Innovive/rack_programer-hardware/Documents/ESP32s pinout.jpg

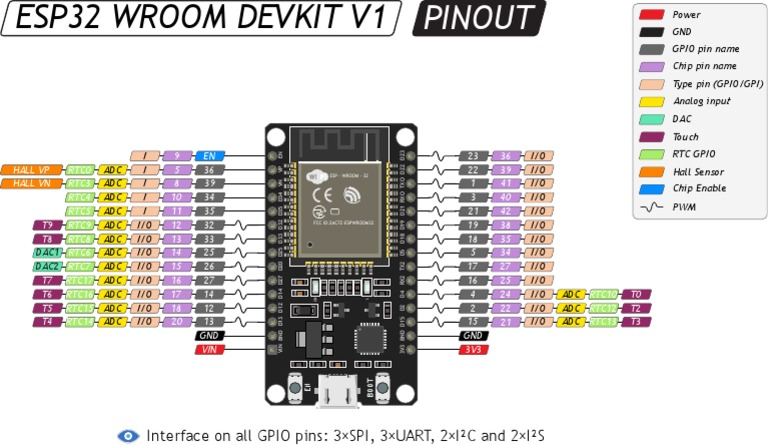
Documents/ESP32s pinout.jpg
