Innovive/rack_programer-hardware/README.md

# rack_programer-hardware
Hardware tool for continuous integration and engineering testing for 3.5 racks
