Innovive/rack_programer-hardware/Documents/CI Device.docx

# Continuous Integration Device

Boost converter website

https://webench.ti.com/power-designer/switching-regulator/customize/5?noparams=0
