Innovive/rack_programer-hardware/Documents/boost converter.PNG

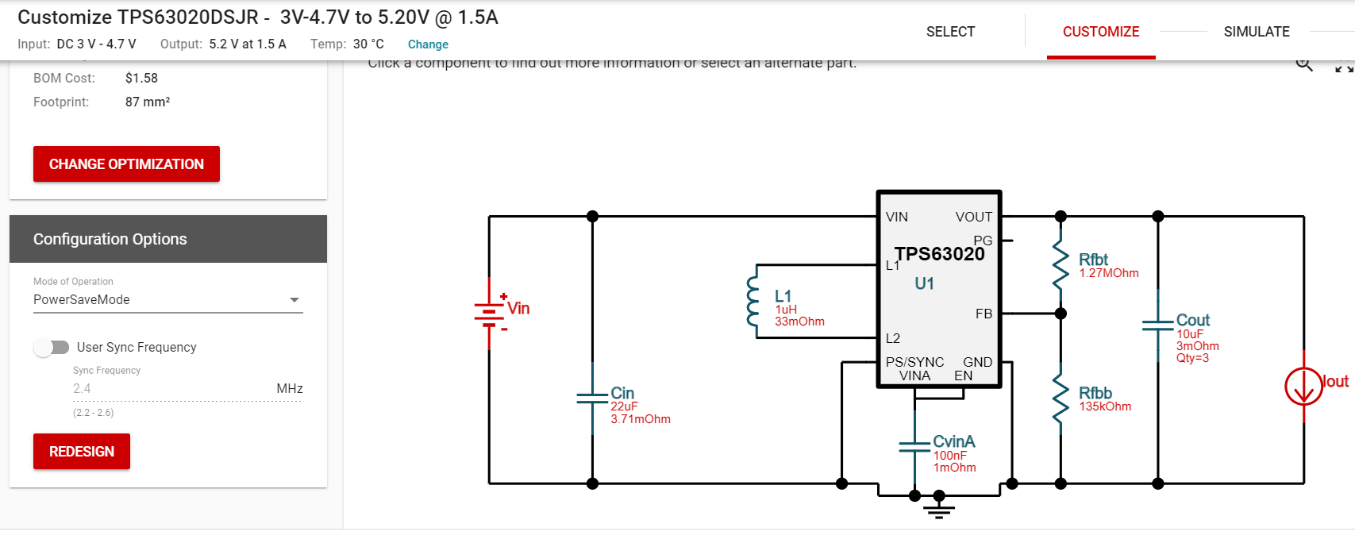
Documents/boost converter.PNG
