Innovive/rack_programer-hardware/Documents/BuckConverter.PNG

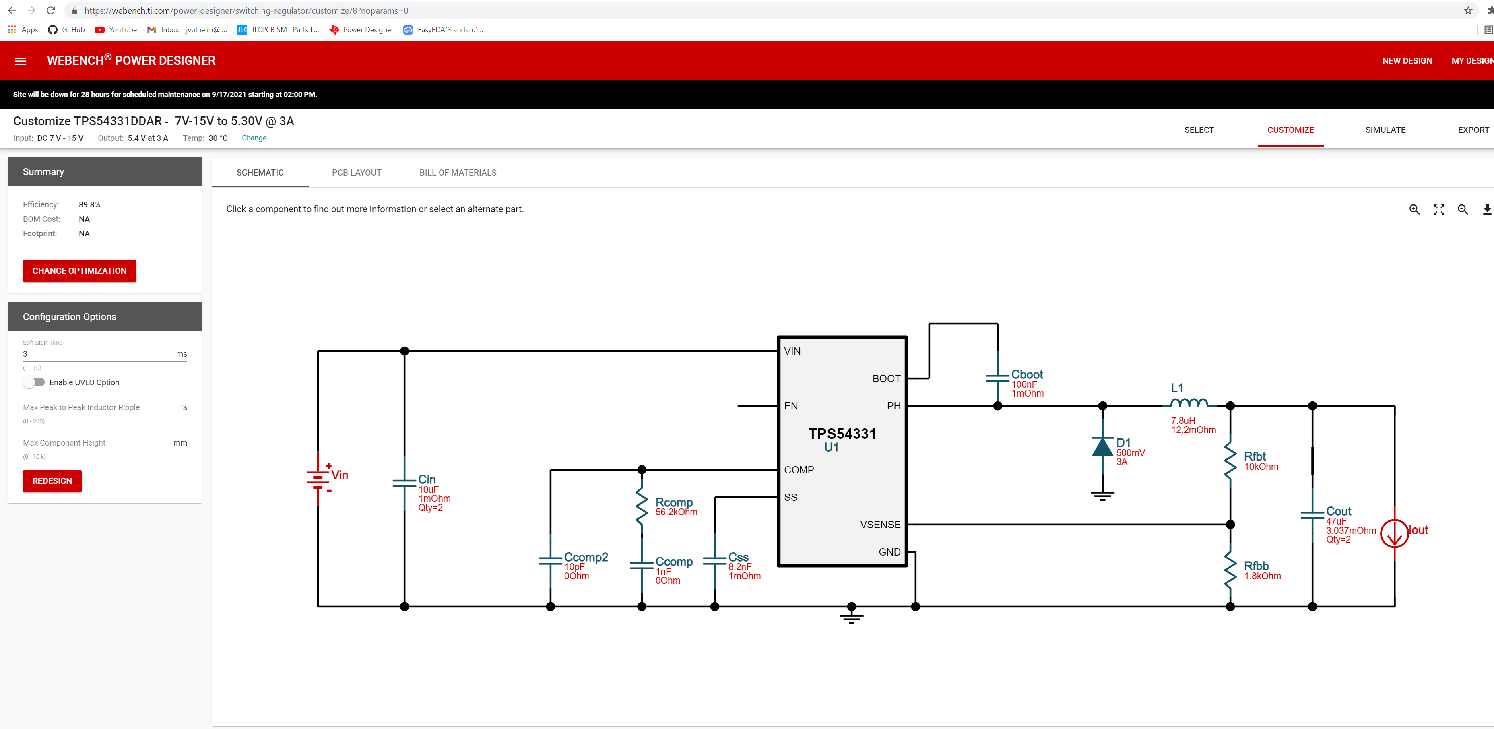
Documents/BuckConverter.PNG
