Innovive/rack_programer-hardware/(threads)

Thread 10 (2021-08-18):

Prevent Controller error while in device mode

jvolheim1, 2021-08-18:
Allow the device to operate while the controller is attached but not erroring out.
will likely require returning values to placate the controller

Thread 3 (2021-08-18):

12v down circuit protection

jvolheim1, 2021-08-18:
design circuit to protect the device from improper voltage from the rack

kalan-innovive, 2021-08-19:
Short circuit or current limiting detection. The board should not draw more than 1.5 Amps

jvolheim1, 2021-09-02:
Add mosfet for reverse voltage protection

jvolheim1, 2021-09-02:
Look at standard ethernet cable pinot to protect the circuit from possible connection with 34v

Thread 5 (2021-08-18):

12v to 5v converter upgrade

jvolheim1, 2021-08-18:
Need a new part or integrated circuit for the device to manage the power coming down from the rack as the current one requires adjustment and in unreliable

Closed 2021-08-24.

Thread 13 (2021-08-19):

4.2v to 5v replacement

jvolheim1, 2021-08-19:
replace the buck converter module in the pcb with a built in circuit design that doesn't need adjustment

Thread 17 (2021-08-19):

Check reverse polarity protection for the battery

jvolheim1, 2021-08-19:
what happens if the battery is put in backwards

Thread 18 (2021-08-19):

Check power losses and reverse currents of diodes in circuit

jvolheim1, 2021-08-19:
We may want to use a p-channel mosfet as show in this video.
https://www.youtube.com/watch?v=IrB-FPcv1Dc

Thread 19 (2021-08-19):

Buck Converter pinning Correction

jvolheim1, 2021-08-19:
The Vi pin and Vo pin are Backwards on the PCB

jvolheim1, 2021-08-19:
Fixed on PCB but will have to flip component on boards coming

Closed 2021-08-19.

Thread 21 (2021-08-24):

Design the power switching circuit

jvolheim1, 2021-08-24:
The power switching circuit should decide base on a hierarchy of rack then usb followed by battery

Thread 28 (2021-08-26):

Create daughter board for rs485 ttl transmitters

jvolheim1, 2021-08-26:
The daughter board should be able to fit on previous device boards and soldered in place of the two separate modules

Closed 2021-09-17.

Thread 35 (2021-09-02):

Add UART to rj485 connector for controller

kalan-innovive, 2021-09-02:
Add UART to RS485 to communicate with the controller on pins 3 and 6 of the RS485 connector.
RS485 pin 6 to the rack should be connected to a GPIO so  that can be pulled low if the controller is connected.

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

Thread 36 (2021-09-17):

12v to 5v test board

jvolheim1, 2021-09-17:
Get a test board printed.
Test the new layout to determine how the circuit behaves.
If the board works appropriately then add it to the main PCB

Thread 37 (2021-09-17):

3.8 to 5v test board

jvolheim1, 2021-09-17:
determine if a board with higher efficiency is needed
Create a test board
Test for effective behavior
if effective then add to main PCB
