Innovive/rack_programer-hardware/CI_ComPCB/CI_ComPCB.kicad_pcb

## KiCad design CI_ComPCB/CI_ComPCB.kicad_pcb (2021-12-14)

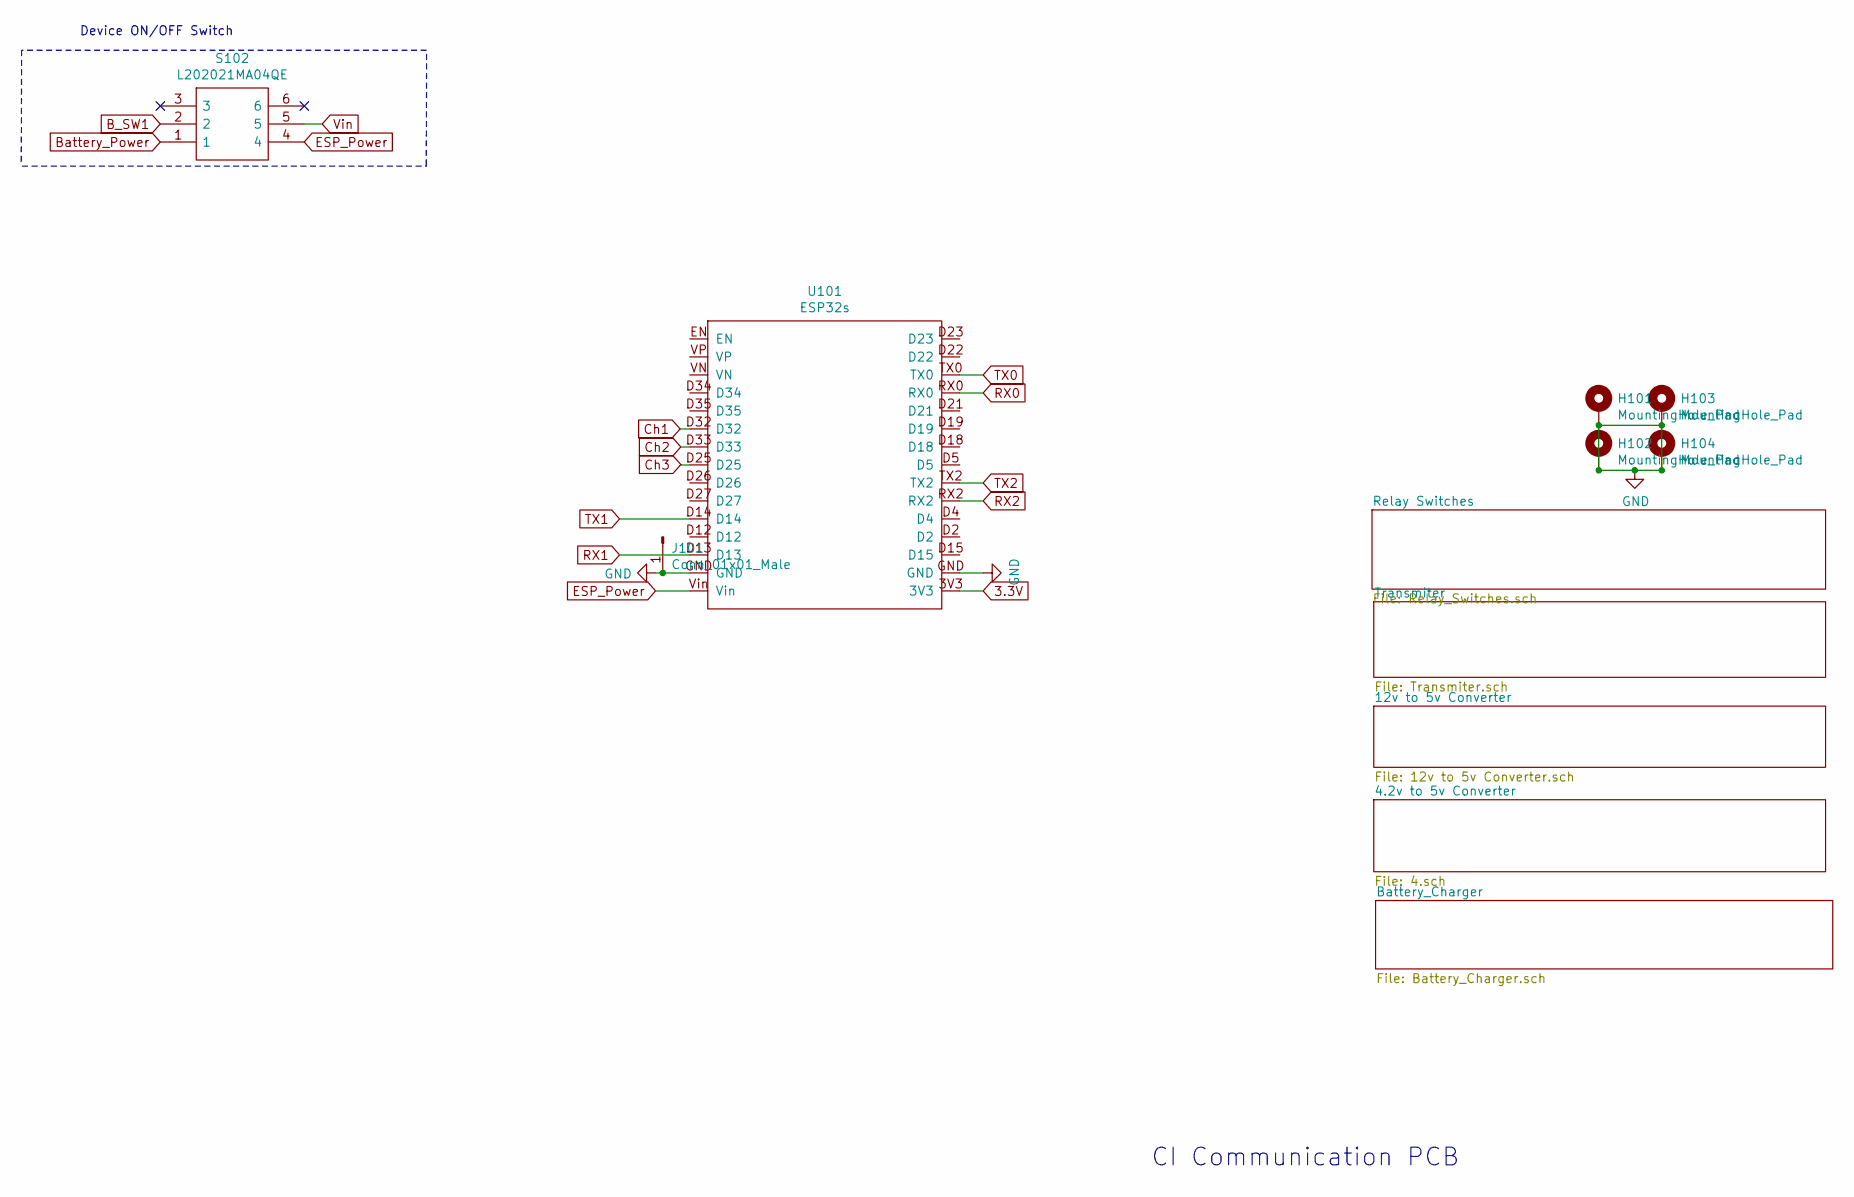
[picture p9: schematic CI_ComPCB.sch]

Parts:
H101, H102, H103, H104: MountingHole_Pad; MountingHole_3.2mm_M3_ISO7380_Pad_TopBottom
J101: Conn_01x01_Male; PinHeader_1x01_P2.54mm_Vertical
S102: L202021MA04QE; Mouser Part Number 611-L202021MA04QE
U101: ESP32s

Connections:
3.3V: U101.3V3; also elsewhere on the board
B_SW1: S102.2; also elsewhere on the board
Battery_Power: S102.1; also elsewhere on the board
Ch1: U101.D32; also elsewhere on the board
Ch2: U101.D33; also elsewhere on the board
Ch3: U101.D25; also elsewhere on the board
ESP_Power: S102.4, U101.Vin
GND: H101.1, H102.1, H103.1, H104.1, J101.1, U101.GND; also elsewhere on the board
RX0: U101.RX0; also elsewhere on the board
RX1: U101.D13; also elsewhere on the board
RX2: U101.RX2; also elsewhere on the board
TX0: U101.TX0; also elsewhere on the board
TX1: U101.D14; also elsewhere on the board
TX2: U101.TX2; also elsewhere on the board
Vin: S102.5; also elsewhere on the board

Notes on the sheet:
CI Communication PCB
Device ON/OFF Switch

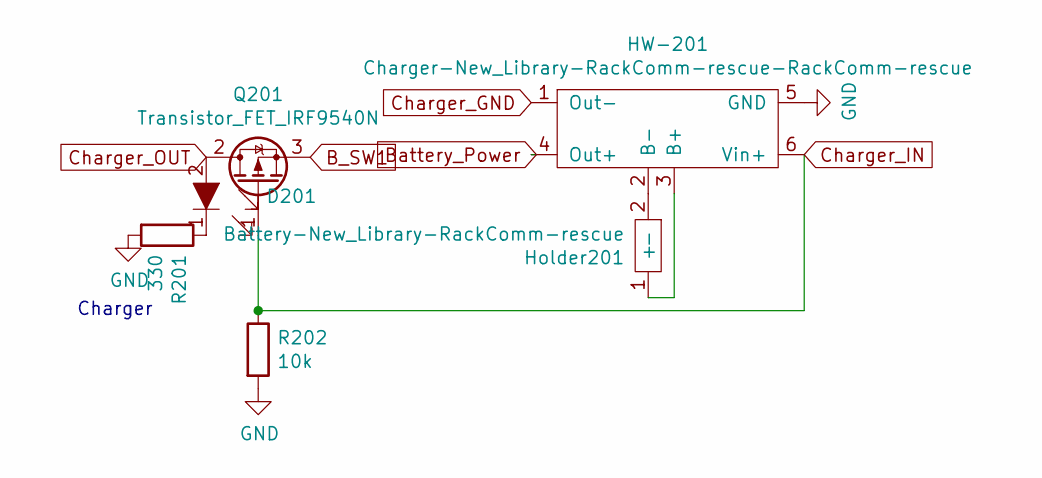
[picture p10: schematic Battery_Charger.sch]

Parts:
D201: LTST-C190GKT; LED_0603; MPN LTST-C190GKT; Digi-Key_PN 160-1183-1-ND
HW-201: Charger-New_Library-RackComm-rescue-RackComm-resc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; Charger
Holder201: Battery-New_Library-RackComm-rescue; Battery
Q201: Transistor_FET_IRF9540N; TO-220-3_Vertical; JLCPCB C2575
R201: 330; R_0805_2012Metric
R202: 10k; R_0805_2012Metric

Connections:
B_SW1: Q201.3 (S); also elsewhere on the board
Battery_Power: HW-201.4 (Out+); also elsewhere on the board
Charger_GND: HW-201.1 (Out-)
Charger_IN: HW-201.6 (Vin+), Q201.1 (G), R202.1; also elsewhere on the board
Charger_OUT: D201.2, Q201.2 (D); also elsewhere on the board
GND: HW-201.5 (GND), R201.2, R202.2; also elsewhere on the board
unnamed: D201.1, R201.1
unnamed: HW-201.2 (B-), Holder201.2 (-)
unnamed: HW-201.3 (B+), Holder201.1 (+)

Notes on the sheet:
Charger

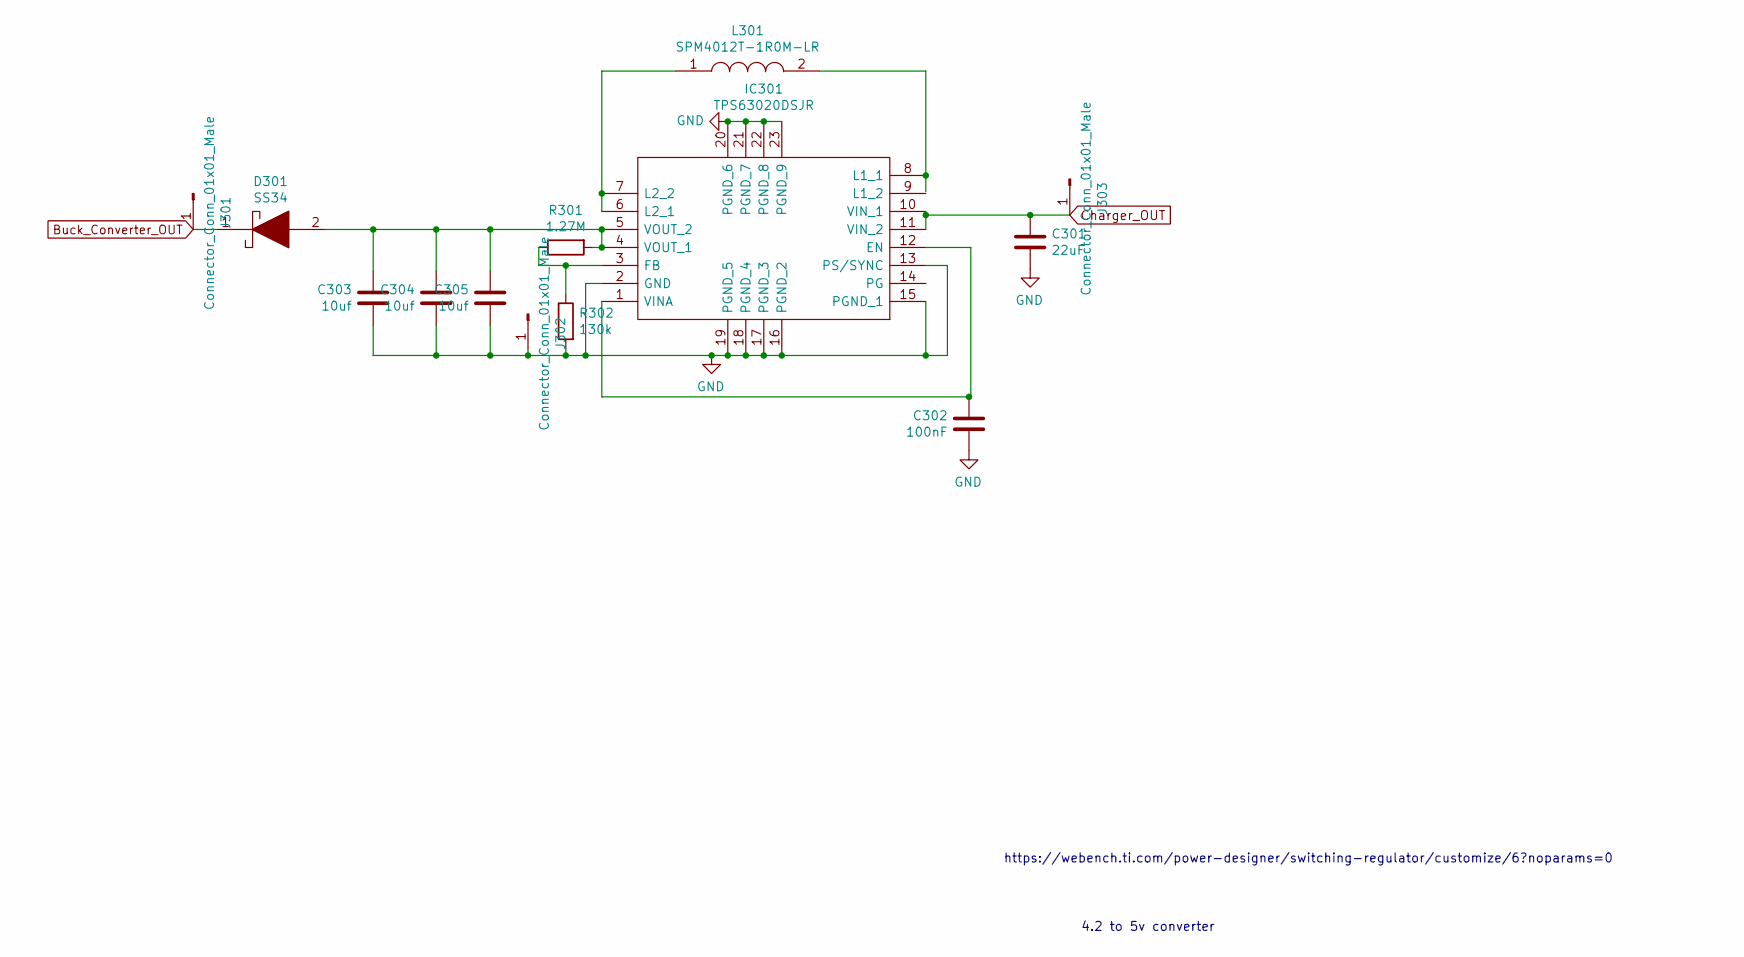
[picture p11: schematic 4.sch]

Parts:
C301: 22uF; C_0805_2012Metric
C302: 100nF; C_0805_2012Metric
C303, C304, C305: 10uf; C_0805_2012Metric
D301: SS34; DO-214AC; Mouser Part Number 512-SS34
IC301: TPS63020DSJR; Mouser Part Number 595-TPS63020DSJR
J301, J302, J303: Connector_Conn_01x01_Male; PinHeader_1x01_P2.54mm_Vertical
L301: SPM4012T-1R0M-LR; SPM4010-4020; Mouser Part Number 810-SPM4012T1R0MLR
R301: 1.27M; R_0603_1608Metric; JLCPCB C166902
R302: 130k; R_0805_2012Metric

Connections:
Buck_Converter_OUT: D301.1, J301.1; also elsewhere on the board
Charger_OUT: C301.1, IC301.10 (VIN_1), IC301.11 (VIN_2), J303.1; also elsewhere on the board
GND: C301.2, C302.2, C303.2, C304.2, C305.2, IC301.2 (GND), IC301.13 (PS/SYNC), IC301.15 (PGND_1), IC301.16 (PGND_2), IC301.17 (PGND_3), IC301.18 (PGND_4), IC301.19 (PGND_5), IC301.20 (PGND_6), IC301.21 (PGND_7), IC301.22 (PGND_8), IC301.23 (PGND_9), J302.1, R302.2; also elsewhere on the board
unnamed: C302.1, IC301.1 (VINA), IC301.12 (EN)
unnamed: C303.1, C304.1, C305.1, D301.2, IC301.4 (VOUT_1), IC301.5 (VOUT_2), R301.2
unnamed: IC301.3 (FB), R301.1, R302.1
unnamed: IC301.6 (L2_1), IC301.7 (L2_2), L301.1
unnamed: IC301.8 (L1_1), L301.2

Notes on the sheet:
4.2 to 5v converter
https://webench.ti.com/power-designer/switching-regulator/customize/6?noparams=0

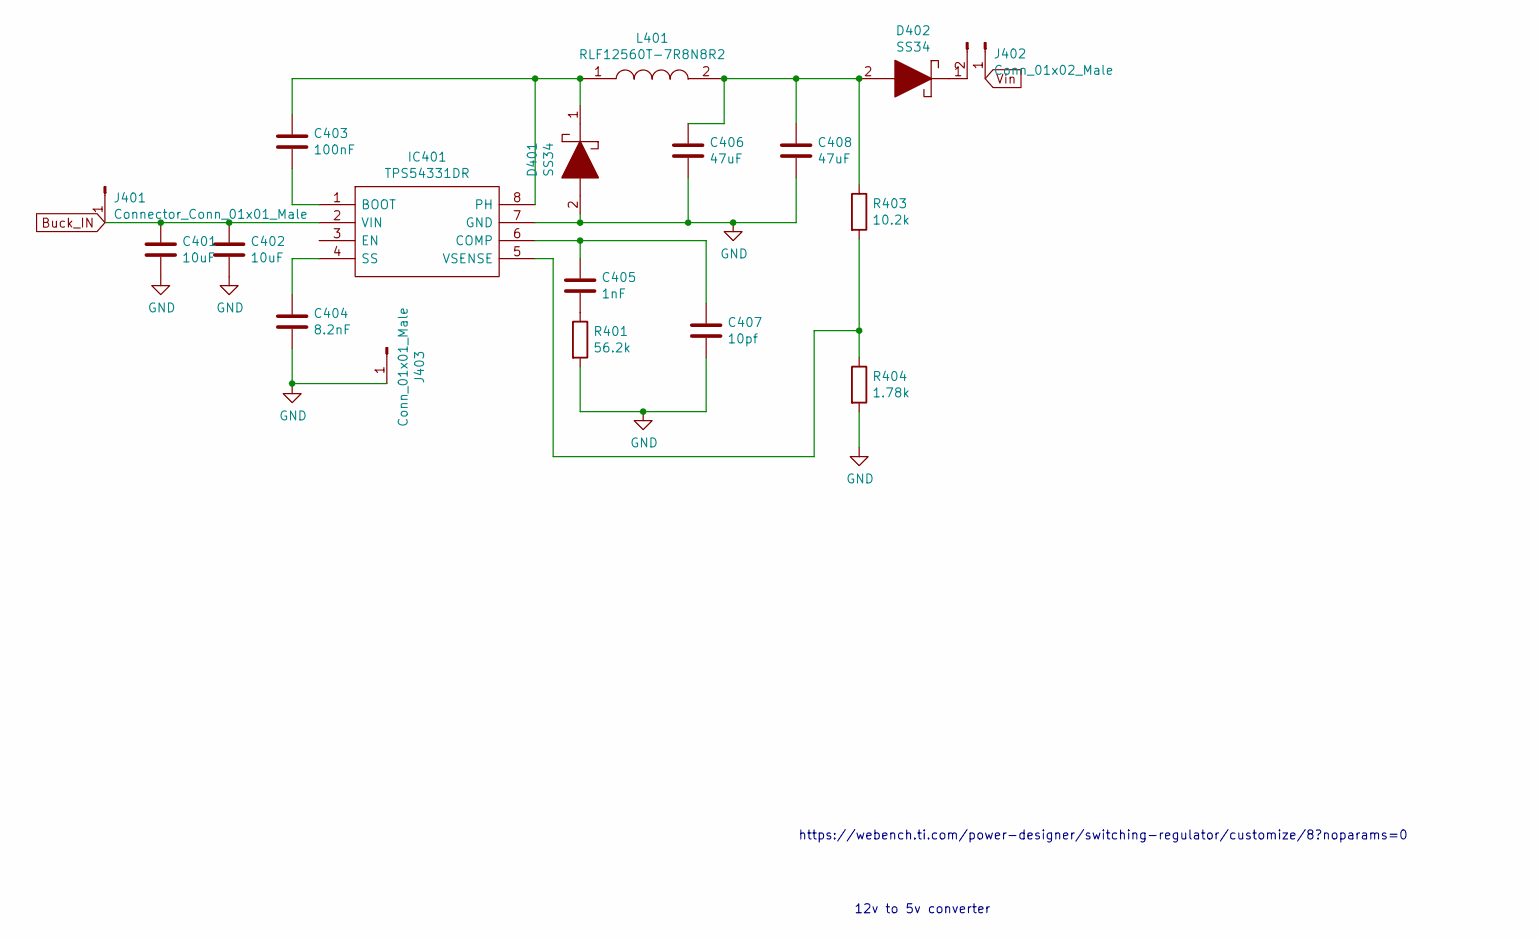
[picture p12: schematic 12v to 5v Converter.sch]

Parts:
C401, C402: 10uF; C_0805_2012Metric
C403: 100nF; C_0805_2012Metric
C404: 8.2nF; C_0603_1608Metric; JLCPCB C1032
C405: 1nF; C_0805_2012Metric
C406, C408: 47uF; C_0805_2012Metric
C407: 10pf; C_0805_2012Metric
D401, D402: SS34; DO-214AC; Mouser Part Number 512-SS34
IC401: TPS54331DR; SOIC127P600X175-8N; Mouser Part Number 595-TPS54331DR
J401: Connector_Conn_01x01_Male; PinHeader_1x01_P2.54mm_Vertical
J402: Conn_01x02_Male; PinHeader_1x02_P2.54mm_Vertical
J403: Conn_01x01_Male; PinHeader_1x01_P2.54mm_Vertical
L401: RLF12560T-7R8N8R2; INDPM128125X600N; Mouser Part Number 810-RLF12560T-7R8N
R401: 56.2k; R_0805_2012Metric
R403: 10.2k; R_0805_2012Metric
R404: 1.78k; R_0805_2012Metric

Connections:
Buck_IN: C401.1, C402.1, IC401.2 (VIN), J401.1; also elsewhere on the board
GND: C401.2, C402.2, C404.2, C406.2, C407.2, C408.2, D401.2, IC401.7 (GND), J403.1, R401.2, R404.2; also elsewhere on the board
unnamed: C403.1, D401.1, IC401.8 (PH), L401.1
unnamed: C403.2, IC401.1 (BOOT)
unnamed: C404.1, IC401.4 (SS)
unnamed: C405.1, C407.1, IC401.6 (COMP)
unnamed: C405.2, R401.1
unnamed: C406.1, C408.1, D402.2, L401.2, R403.1
unnamed: D402.1, J402.2
unnamed: IC401.5 (VSENSE), R403.2, R404.1
Vin: J402.1; also elsewhere on the board

Notes on the sheet:
12v to 5v converter
https://webench.ti.com/power-designer/switching-regulator/customize/8?noparams=0

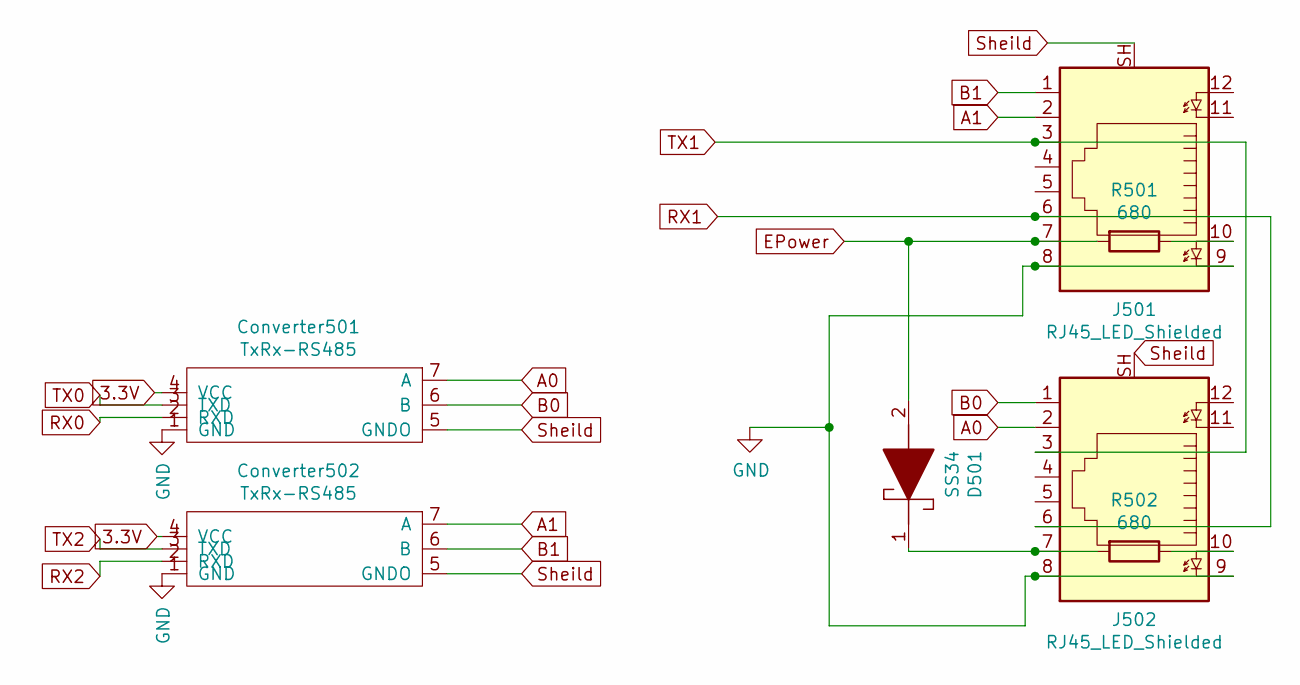
[picture p13: schematic Transmiter.sch]

Parts:
Converter501, Converter502: TxRx-RS485; TXRX-AB
D501: SS34; DO-214AC; Mouser Part Number 512-SS34
J501: RJ45_LED_Shielded; RJ45_Amphenol_RJHSE538X
J502: RJ45_LED_Shielded; RJ45_Amphenol_RJHSE538X; JLCPCB C464588
R501, R502: 680; R_0805_2012Metric

Connections:
3.3V: Converter501.4 (VCC), Converter502.4 (VCC); also elsewhere on the board
A0: Converter501.7 (A), J502.2
A1: Converter502.7 (A), J501.2
B0: Converter501.6 (B), J502.1
B1: Converter502.6 (B), J501.1
EPower: D501.2, J501.7, R501.2; also elsewhere on the board
GND: Converter501.1 (GND), Converter502.1 (GND), J501.8, J501.9, J502.8, J502.9; also elsewhere on the board
unnamed: D501.1, J502.7, R502.2
unnamed: J501.10, R501.1
unnamed: J502.10, R502.1
RX0: Converter501.2 (RXD); also elsewhere on the board
RX1: J501.6, J502.6; also elsewhere on the board
RX2: Converter502.2 (RXD); also elsewhere on the board
Sheild: Converter501.5 (GNDO), Converter502.5 (GNDO), J501.SH, J502.SH
TX0: Converter501.3 (TXD); also elsewhere on the board
TX1: J501.3, J502.3; also elsewhere on the board
TX2: Converter502.3 (TXD); also elsewhere on the board

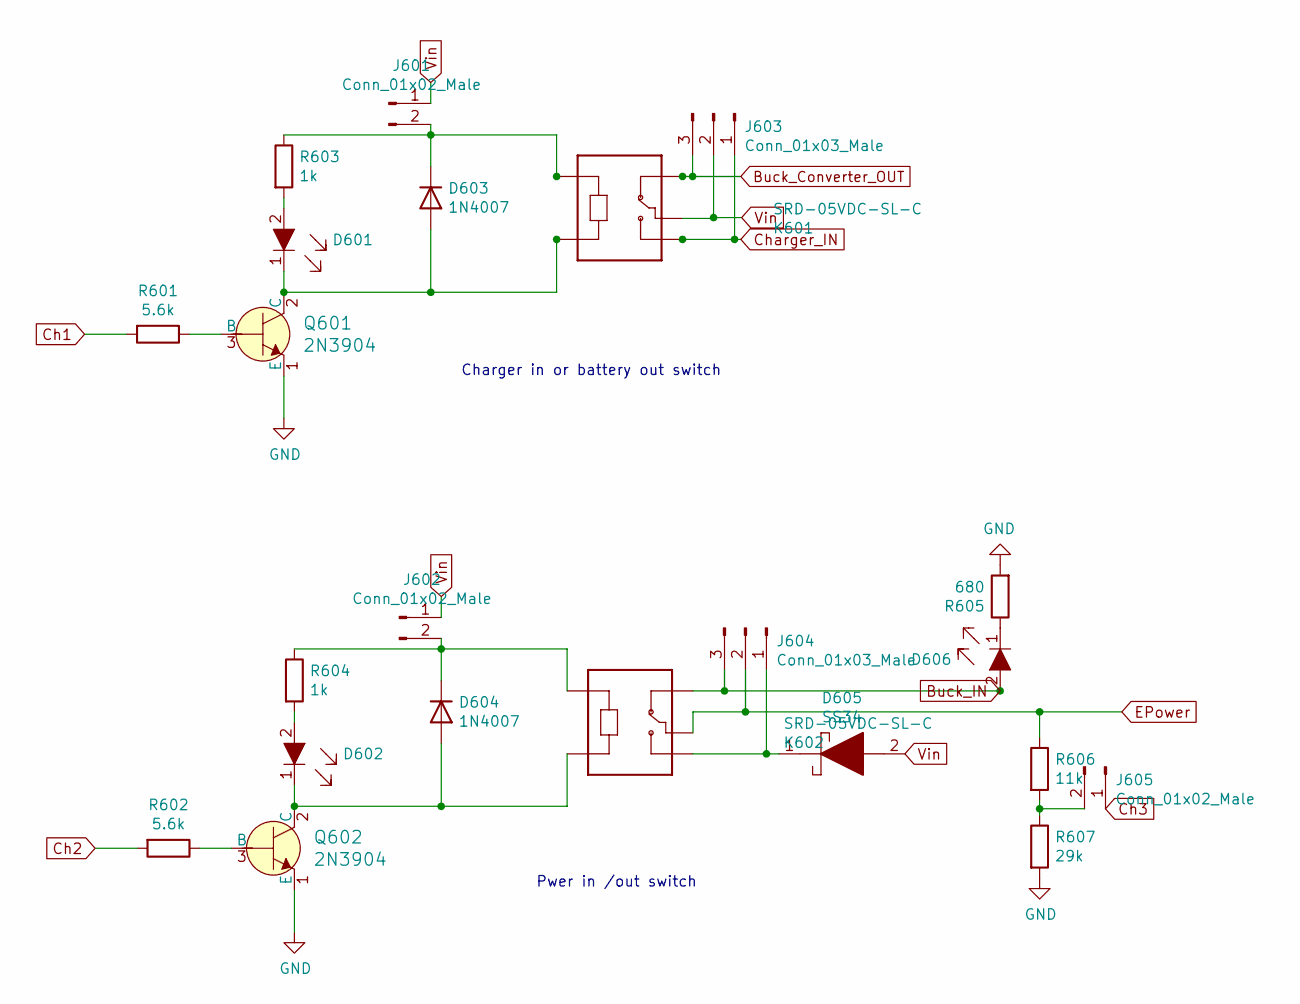
[picture p14: schematic Relay_Switches.sch]

Parts:
D601, D602, D606: LTST-C190GKT; LED_0603; MPN LTST-C190GKT; Digi-Key_PN 160-1183-1-ND
D603, D604: 1N4007; DO-214AC
D605: SS34; DO-214AC; Mouser Part Number 512-SS34
J601, J602, J605: Conn_01x02_Male; PinHeader_1x02_P2.54mm_Vertical
J603, J604: Conn_01x03_Male; PinHeader_1x03_P2.54mm_Vertical
K601, K602: SRD-05VDC-SL-C; RELAY_SRD-05VDC-SL-C; Manufacturer_Part_Number SRD-05VDC-SL-C
Q601, Q602: 2N3904; TO-92-3; MPN 2N3904; Digi-Key_PN 2N3904CS-ND
R601, R602: 5.6k; R_0805_2012Metric
R603, R604: 1k; R_0805_2012Metric
R605: 680; R_0805_2012Metric
R606: 11k; R_0805_2012Metric
R607: 29k; R_0805_2012Metric

Connections:
Buck_Converter_OUT: J603.3, K601.NC; also elsewhere on the board
Buck_IN: D606.2, J604.3, K602.NC; also elsewhere on the board
Ch1: R601.2; also elsewhere on the board
Ch2: R602.2; also elsewhere on the board
Ch3: J605.1; also elsewhere on the board
Charger_IN: J603.1, K601.NO; also elsewhere on the board
EPower: J604.2, K602.COM, R606.1; also elsewhere on the board
GND: Q601.1 (E), Q602.1 (E), R605.2, R607.2; also elsewhere on the board
unnamed: D601.1, D603.2 (A), K601.A1, Q601.2 (C)
unnamed: D601.2, R603.2
unnamed: D602.1, D604.2 (A), K602.A1, Q602.2 (C)
unnamed: D602.2, R604.2
unnamed: D603.1 (K), J601.2, K601.A2, R603.1
unnamed: D604.1 (K), J602.2, K602.A2, R604.1
unnamed: D605.1, J604.1, K602.NO
unnamed: D606.1, R605.1
unnamed: J605.2, R606.2, R607.1
unnamed: Q601.3 (B), R601.1
unnamed: Q602.3 (B), R602.1
Vin: D605.2, J601.1, J602.1, J603.2, K601.COM; also elsewhere on the board

Notes on the sheet:
Pwer in /out switch
Charger in or battery out switch

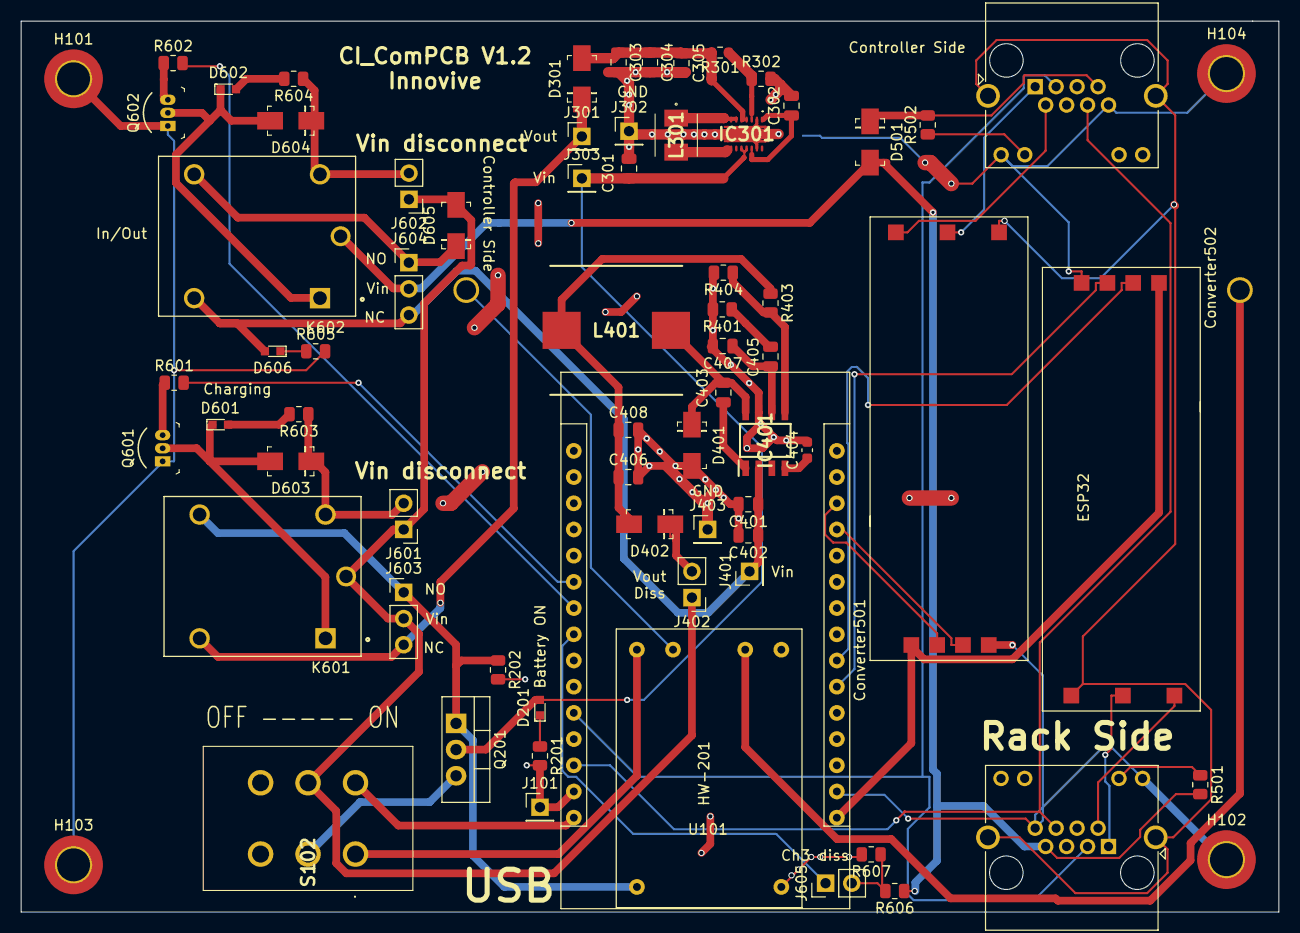
[picture p15: board CI_ComPCB.kicad_pcb from above]

Board: 2 copper layers, 121.9 x 86.4 mm, 73 parts (1 on the bottom side), 55 nets.
