Innovive/rack_programer-hardware/CI_ComPCB/12 to 5v converter/12 to 5v converter.kicad_pcb

## KiCad design CI_ComPCB/12 to 5v converter/12 to 5v converter.kicad_pcb (2021-09-17)

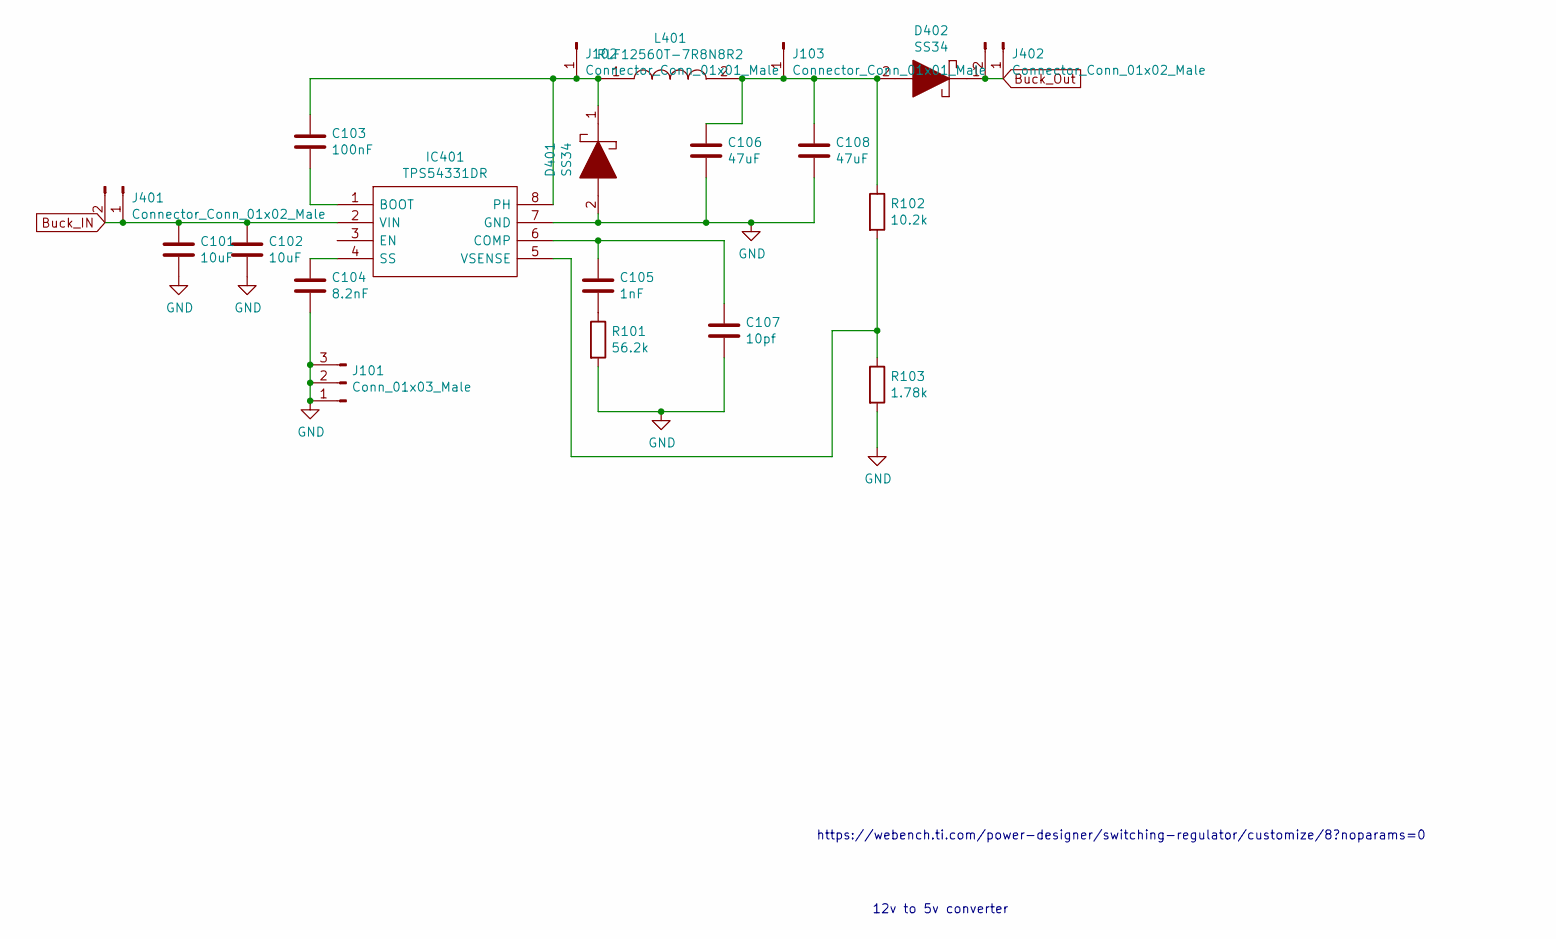
[picture p16: schematic 12 to 5v converter.sch]

Parts:
C101, C102: 10uF; C_0805_2012Metric
C103: 100nF; C_0805_2012Metric
C104: 8.2nF; C_0805_2012Metric; JLCPCB C1032
C105: 1nF; C_0805_2012Metric
C106, C108: 47uF; C_0805_2012Metric
C107: 10pf; C_0805_2012Metric
D401, D402: SS34; DO-214AC; Mouser Part Number 512-SS34
IC401: TPS54331DR; SOIC127P600X175-8N; Mouser Part Number 595-TPS54331DR
J101: Conn_01x03_Male; PinHeader_1x03_P2.54mm_Vertical
J102, J103: Connector_Conn_01x01_Male; PinHeader_1x01_P2.54mm_Vertical
J401, J402: Connector_Conn_01x02_Male; PinHeader_1x02_P2.54mm_Vertical
L401: RLF12560T-7R8N8R2; INDPM128125X600N; Mouser Part Number 810-RLF12560T-7R8N
R101: 56.2k; R_0805_2012Metric
R102: 10.2k; R_0805_2012Metric
R103: 1.78k; R_0805_2012Metric

Connections:
Buck_IN: C101.1, C102.1, IC401.2 (VIN), J401.1, J401.2
Buck_Out: D402.1, J402.1, J402.2
GND: C101.2, C102.2, C104.2, C106.2, C107.2, C108.2, D401.2, IC401.7 (GND), J101.1, J101.2, J101.3, R101.2, R103.2
unnamed: C103.1, D401.1, IC401.8 (PH), J102.1, L401.1
unnamed: C103.2, IC401.1 (BOOT)
unnamed: C104.1, IC401.4 (SS)
unnamed: C105.1, C107.1, IC401.6 (COMP)
unnamed: C105.2, R101.1
unnamed: C106.1, C108.1, D402.2, J103.1, L401.2, R102.1
unnamed: IC401.5 (VSENSE), R102.2, R103.1

Notes on the sheet:
12v to 5v converter
https://webench.ti.com/power-designer/switching-regulator/customize/8?noparams=0

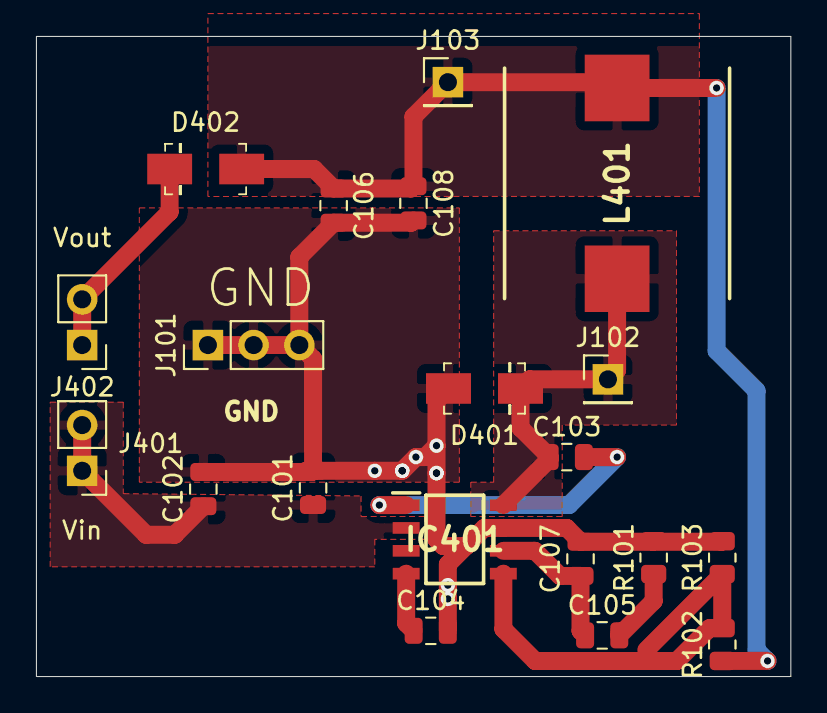
[picture p17: board 12 to 5v converter.kicad_pcb from above]

Board: 2 copper layers, 41.9 x 35.6 mm, 20 parts (0 on the bottom side), 10 nets.
