Innovive/rack_programer-hardware/CI_ComPCB/Max 485 transmitter/Max 485 transmitter.kicad_pcb

## KiCad design CI_ComPCB/Max 485 transmitter/Max 485 transmitter.kicad_pcb (2021-09-17)

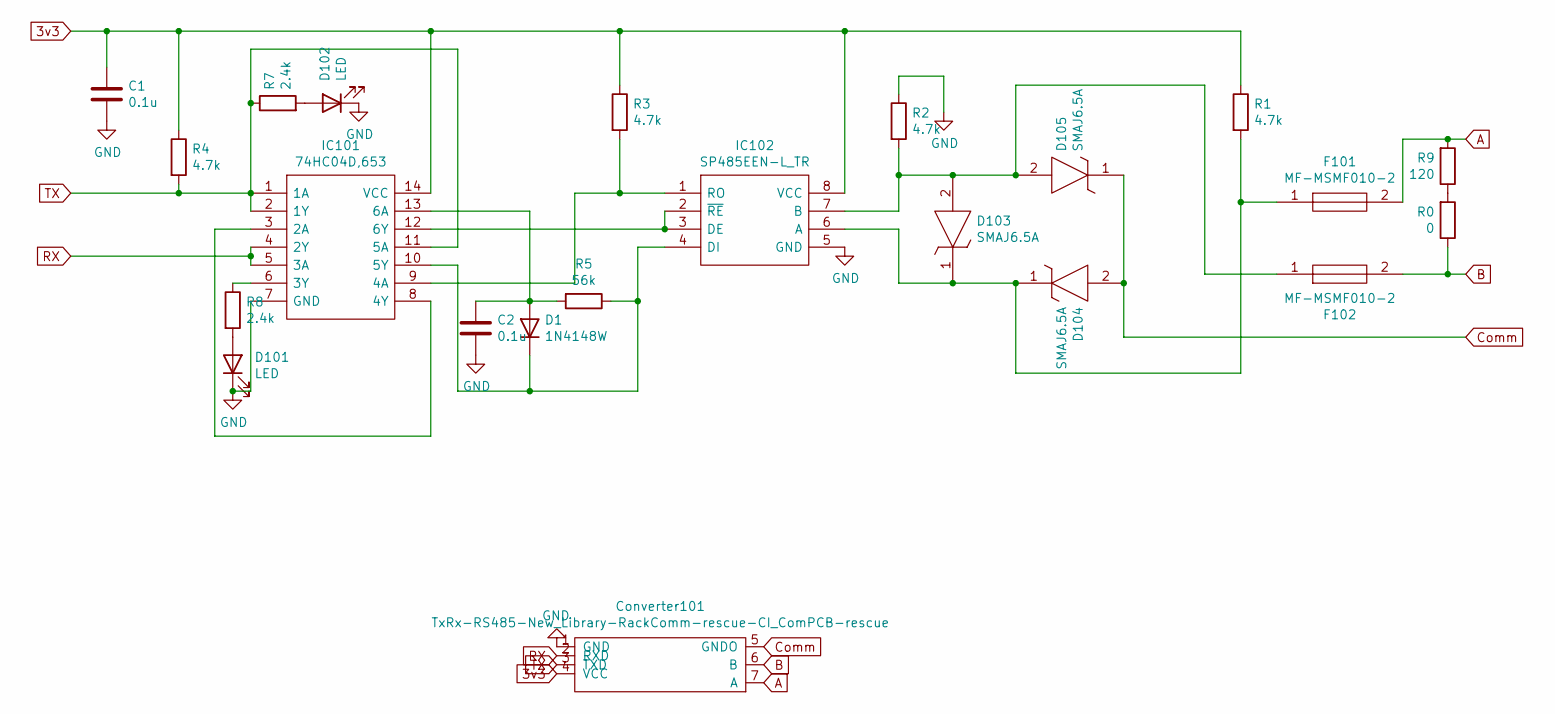
[picture p18: schematic Max 485 transmitter.sch]

Parts:
C1, C2: 0.1u; C_0402_1005Metric
Converter101: TxRx-RS485-New_Library-RackComm-rescue-CI_ComPCB-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; TXRX-AB
D1: 1N4148W; D_SOD-123
D101, D102: LED; LED_0603
D103, D104, D105: SMAJ6.5A; DIOM5026X229N; Mouser Part Number 576-SMAJ6.5A
F101, F102: MF-MSMF010-2; FUSC4632X110N; Mouser Part Number 652-MF-MSMF010-2
IC101: 74HC04D,653; SOIC127P600X175-14N; Mouser Part Number 771-74HC04D-T
IC102: SP485EEN-L_TR; SOIC127P600X175-8N; Mouser Part Number 701-SP485EEN-L/TR
R0: 0; R_0402_1005Metric
R1, R2, R3, R4: 4.7k; R_0402_1005Metric
R5: 56k; R_0402_1005Metric
R7, R8: 2.4k; R_0402_1005Metric
R9: 120; R_0402_1005Metric

Connections:
3v3: C1.1, Converter101.4 (VCC), IC101.14 (VCC), IC102.8 (VCC), R1.1, R3.1, R4.1
A: Converter101.7 (A), F101.2, R9.2
B: Converter101.6 (B), F102.2, R0.1
Comm: Converter101.5 (GNDO), D104.2, D105.1
GND: C1.2, C2.2, Converter101.1 (GND), D101.1 (K), D102.1 (K), IC101.7 (GND), IC102.5 (GND), R2.1
unnamed: C2.1, D1.2 (A), IC101.13 (6A), R5.2
unnamed: D1.1 (K), IC101.10 (5Y), IC102.4 (DI), R5.1
unnamed: D101.2 (A), R8.2
unnamed: D102.2 (A), R7.2
unnamed: D103.1, D104.1, F101.1, IC102.6 (A), R1.2
unnamed: D103.2, D105.2, F102.1, IC102.7 (B), R2.2
unnamed: IC101.3 (2A), IC101.8 (4Y)
unnamed: IC101.6 (3Y), R8.1
unnamed: IC101.9 (4A), IC102.1 (RO), R3.2
unnamed: IC101.12 (6Y), IC102.2 (~RE), IC102.3 (DE)
unnamed: R0.2, R9.1
RX: Converter101.2 (RXD), IC101.4 (2Y), IC101.5 (3A)
TX: Converter101.3 (TXD), IC101.1 (1A), IC101.2 (1Y), IC101.11 (5A), R4.2, R7.1

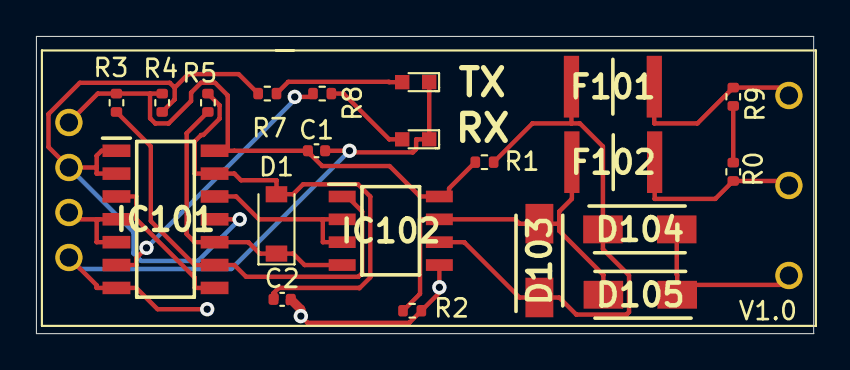
[picture p19: board Max 485 transmitter.kicad_pcb from above]

Board: 2 copper layers, 43.2 x 16.5 mm, 22 parts (0 on the bottom side), 18 nets.
