Innovive/rack_programer-hardware/(commit log)

2021-08-18 Started new project for CI pcb
    [CI_ComPCB.kicad_pcb, CI_ComPCB.sch]
2021-08-18 Create CI Device.docx
2021-08-19 First PCB
    First PCB Printed with minor alterations
    [CI_ComPCB-2021-08-19-13-28-57.sch, CI_ComPCB-2021-08-19-13-30-51.sch, CI_ComPCB.kicad_pcb]
2021-08-20 Rough V1
    [CI_ComPCB.kicad_pcb, CI_ComPCB.sch]
2021-08-24 V1 w/ no Battery
    [CI_ComPCB.kicad_pcb, CI_ComPCB.sch]
2021-08-24 V1 w/ no Battery
    upgrade from first draft fixing issues #5 #20 #15 #12 #11 #6
    [CI_ComPCB.kicad_pcb]
2021-08-25 PCB Library upload
2021-08-25 V1.1 working progress
    Implemented further documentation
    New boost converter for the battery
    power switches
    Led indicator
    removed unnecessary elements
    [CI_ComPCB.kicad_pcb, CI_ComPCB.sch]
2021-08-26 V1.1 in development
    Implemented sheets
    Added correct switches
    Completed boost converter
    REQUIRED before build:
    PCB layout
    Component matching with PCB maker
    [12v to 5v Converter.sch, 4.sch, Battery_Charger.sch, CI_ComPCB.kicad_pcb, CI_ComPCB.sch, Transmiter.sch]
2021-08-27 V1.1 in progress
    Completed Bom and schematic
    still need to add routs and PCB layout
    [12v to 5v Converter.sch, 4.sch, Battery_Charger.sch, CI_ComPCB.kicad_pcb, CI_ComPCB.sch, Transmiter.sch]
2021-08-28 V1.1 Rough
    Almost complete
    needs silk screen annotations then will be ready to have printed
    [12v to 5v Converter.sch, 4.sch, Battery_Charger.sch, CI_ComPCB.kicad_pcb, CI_ComPCB.sch, Transmiter.sch]
2021-08-30 V1.1 Check
    Ready to print after final checks and adjustments
    [CI_ComPCB.kicad_pcb]
2021-08-30 V1.1 board
    Board is ready to print
    [12v to 5v Converter.sch, Battery_Charger.sch, CI_ComPCB.kicad_pcb]
2021-08-30 V1 Complete
    [CI_ComPCB-NPTH.drl, CI_ComPCB-PTH.drl]
2021-08-30 Added bom file
    [Bom 1.csv, CI_ComPCB.csv, boost converter bom.csv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]
2021-08-30 gerber files added
    [CI_ComPCB-NPTH.drl, CI_ComPCB-PTH.drl]
2021-08-31 V1.1 Changed Diode for reprint
    [12v to 5v Converter.sch, 4.sch, Bom 1.csv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]
2021-09-02 V1.2 Beginning
    Created transmitter module
    [Max 485 transmitter-B_Cu.gbr, Max 485 transmitter-B_Mask.gbr, Max 485 transmitter-B_Paste.gbr, Max 485 transmitter-B_SilkS.gbr, Max 485 transmitter-Edge_Cuts.gbr, Max 485 transmitter-F_Cu.gbr, Max 485 transmitter-F_Mask.gbr, Max 485 transmitter-F_Paste.gbr]
2021-09-03 Transmitter print
    [Max 485 transmitter Bom.csv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]
2021-09-08 transmitter update
    [Max 485 transmitter Bom.csv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]
2021-09-17 converters debug
    [12 to 5v converter.kicad_pcb, 12 to 5v converter.sch, 4.2 to 5v converter.kicad_pcb, 4.2 to 5v converter.sch, 4.sch, CI_ComPCB.kicad_pcb, Max 485 transmitter.kicad_pcb, Transmiter.sch]
2021-10-29 Ready to Build
    [12v to 5v Converter.sch, 4.sch, Battery_Charger.sch, Bom 1.csv, Bom.csv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]
2022-02-04 Move to Sub Folder
    Moved unrelated projects to a different repository called innovive Sub Projects
    [Ethernet Splitter-B_Cu.gbr, Ethernet Splitter-B_Mask.gbr, Ethernet Splitter-B_Paste.gbr, Ethernet Splitter-B_SilkS.gbr, Ethernet Splitter-Edge_Cuts.gbr, Ethernet Splitter-F_Cu.gbr, Ethernet Splitter-F_Mask.gbr, Ethernet Splitter-F_Paste.gbr]
